aaron3481/bitaxe/(commit log)

2024-01-08 add fill
    [bitaxeUltra.kicad_pcb]
2024-03-21 Add LED-RF-Controller.kicad_mod
2024-03-21 Init commit to TCH-204 Black edition with LED lights
    [bitaxeUltra.kicad_pcb]
2024-03-21 Finish LED layout. Can pass to factory for prototype test
    [bitaxeUltra.kicad_pcb, bitaxeUltra.kicad_sch, bm1366.kicad_sch, esp32.kicad_sch, fan.kicad_sch, led_control.kicad_sch, power.kicad_sch]
2024-03-21 Add Black Edition logo
    [bitaxeUltra.kicad_pcb]
2024-04-06 Fix Led wiring issue
    [bitaxeUltra.kicad_pcb]
2024-04-16 Upload gerbers files
    [BOM_JCLPcb.xls, bitaxeUltra BOM.xlsx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]
